Ciaanh/keyboards/Kanagawa/Oled/oled.md

https://randomnerdtutorials.com/guide-for-oled-display-with-arduino/

https://blog.squix.org/2016/10/font-creator-now-creates-adafruit-gfx-fonts.html

http://oleddisplay.squix.ch/#/home

https://joric.github.io/qle/  =>  fork https://github.com/Ciaanh/qle

http://teripom.x0.com/  => KO
https://helixfonteditor.netlify.com/
https://gist.github.com/teriyakichan/f1a38cd4c0ddd1238be15c48c8cf47d2
https://github.com/teriyakichan/helixfonteditor

https://github.com/qmk/qmk_firmware/issues/6650
