Ciaanh/keyboards/Kanagawa/rev2.1/kanagawa.jpg

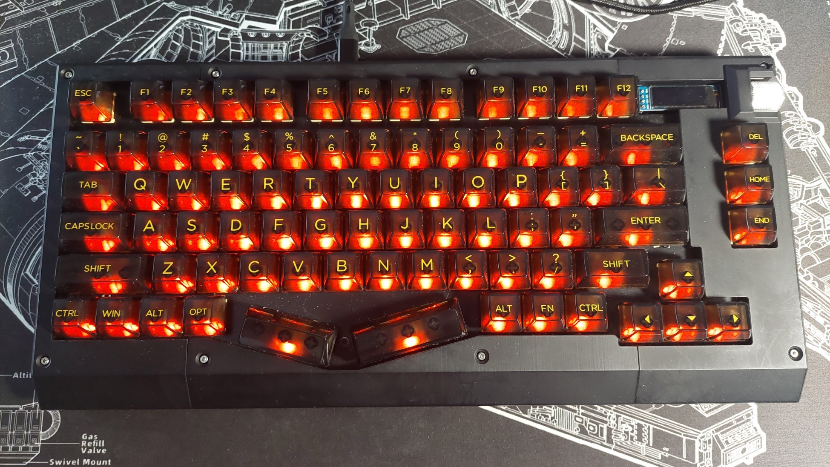
Kanagawa/rev2.1/kanagawa.jpg
