Ciaanh/keyboards/Kanagawa/rev2.1/kanagawa_built.jpg

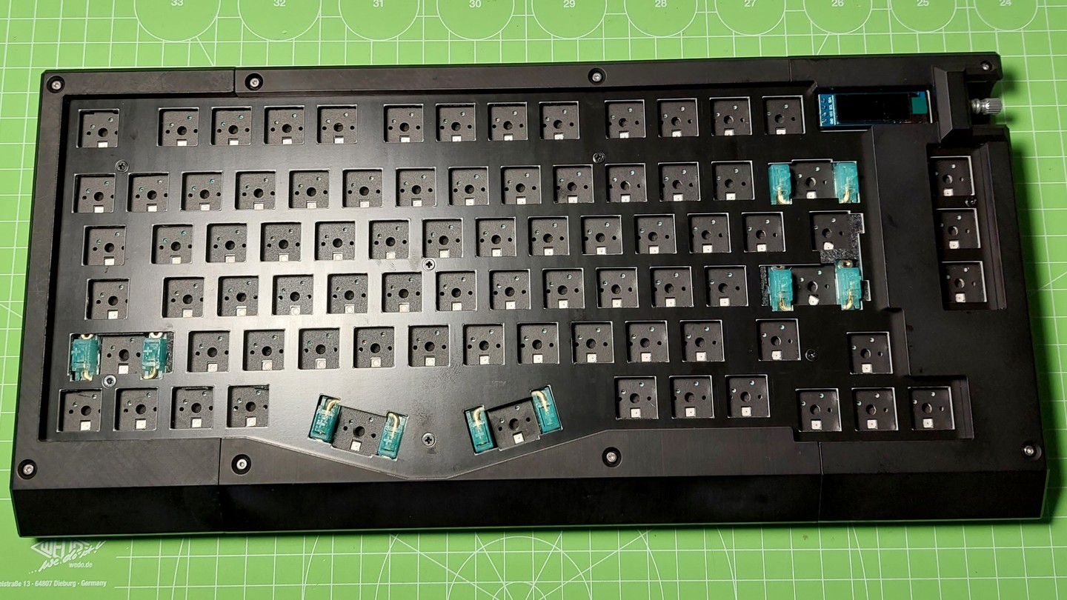
Kanagawa/rev2.1/kanagawa_built.jpg
