Ciaanh/keyboards/talk/pictures/Situation-under-control.png

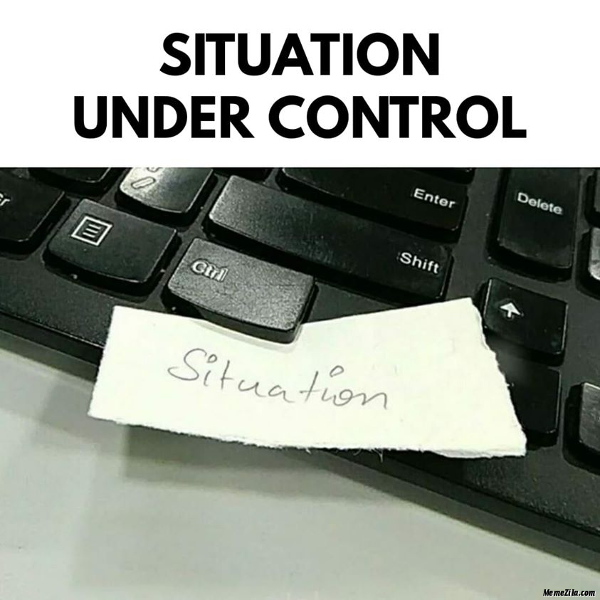
talk/pictures/Situation-under-control.png
