Ciaanh/keyboards/Board_MCU.xlsx

Sheet: Atmega32U4
Usage | Pin
 | B0
 | B1
 | B2
 | B3
 | B4
 | B5
 | B6
 | B7
 | C6
 | C7
 | D0
 | D1
 | D2
 | D3
 | D4
 | D5
 | D6
 | D7
 | E6
 | F0
 | F1
 | F4
 | F5
 | F6
 | F7

Sheet: Kanagawa
Label | Pin
col00 | B6
col01 | F0
col02 | F1
col03 | C7
col04 | D5
col05 | B7
col06 | B5
col07 | B4
col08 | E6
co0l9 | D7
col10 | C6
col11 | D4
col12 | D2
col13 | D3
row00 | B2
row01 | B3
row02 | B1
row03 | F7
row04 | F6
row05 | F5
SDA | D1
SCL | D0
ENCA | B0
ENCB | F4
RESET
VCC
GND

Sheet: Kanagawa RGB
Label | Pin
col00 | F1
col01 | C7
col02 | D5
col03 | B7
col04 | B5
col05 | B4
col06 | E6
col07 | D7
col08 | C6
co0l9 | D4
col10 | D3
col11 | D2
row00 | F0
row01 | B6
row02 | B2
row03 | B3
row04 | B1
row05 | F7
row06 | F6
SDA | D1
SCL | D0
RGB | B0
ENCA | F5
ENCB | F4
RESET
VCC
GND

Sheet: Kanagawa RGB Pico
Label | Pin Pico
col00 | GPIO2
col01 | GPIO3
col02 | GPIO4
col03 | GPIO5
col04 | GPIO6
col05 | GPIO7
col06 | GPIO8
col07 | GPIO9
col08 | GPIO10
co0l9 | GPIO11
col10 | GPIO12
col11 | GPIO13
col12 | GPIO14
col13 | GPIO15
row00 | GPIO27
row01 | GPIO26
row02 | GPIO21
row03 | GPIO20
row04 | GPIO19
row05 | GPIO18
SDA | GPIO16
SCL | GPIO17
RGB | GPIO28
ENCA | GPIO1
ENCB | GPIO0
RESET
VCC
GND
