Ciaanh/keyboards/Kanagawa/rev2.1/case/right.stl

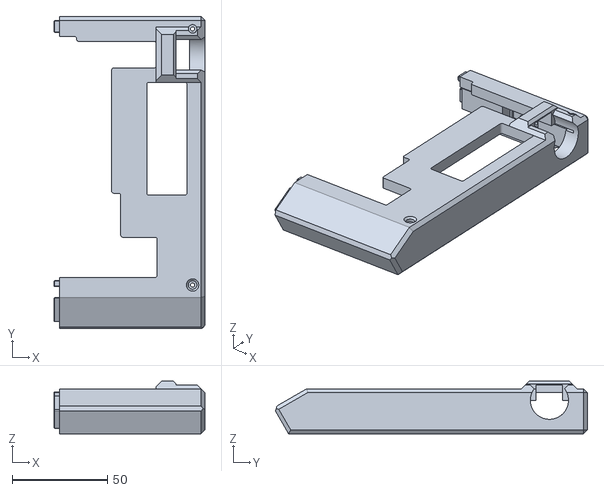
[picture p46: CAD file, 2023-05-08]
Kanagawa/rev2.1/case/right.stl
79.2 x 163.7 x 27.6
