Ciaanh/keyboards/Kanagawa/rev2.1/PCB_Projection_revised.dxf

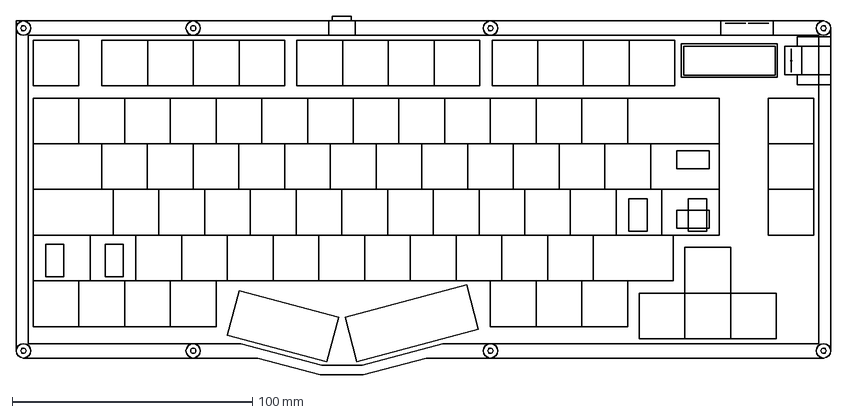
[picture p47: CAD file, 2023-04-29]
Kanagawa/rev2.1/PCB_Projection_revised.dxf
339.2 x 149.4 mm
