Ciaanh/keyboards/Kanagawa/rev2.1/case/top.stl

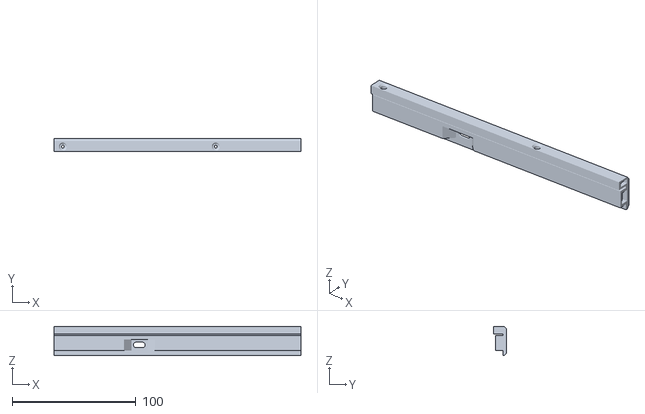
[picture p48: CAD file, 2023-05-08]
Kanagawa/rev2.1/case/top.stl
200.0 x 10.5 x 23.6
