Ciaanh/keyboards/Kanagawa/rev2.1/case/left.stl

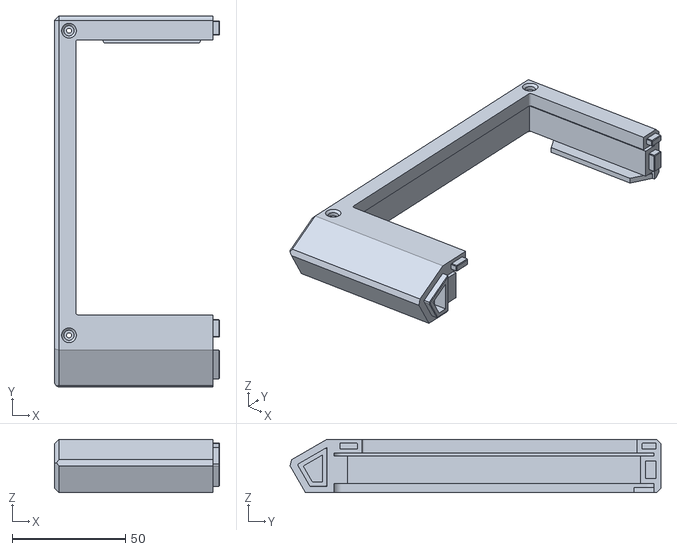
[picture p49: CAD file, 2023-05-08]
Kanagawa/rev2.1/case/left.stl
73.0 x 163.7 x 23.6
