Ciaanh/keyboards/Kanagawa/rev2.1/case/bottom.stl

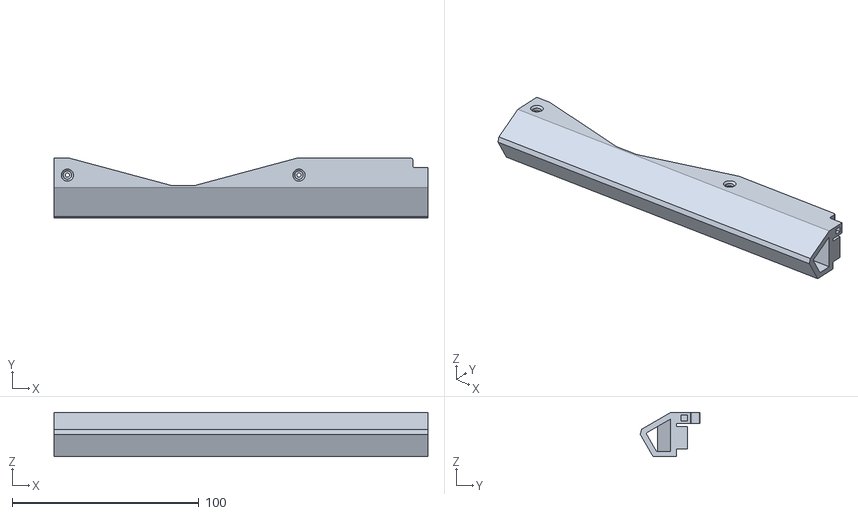
[picture p50: CAD file, 2023-05-08]
Kanagawa/rev2.1/case/bottom.stl
200.0 x 31.9 x 23.6
