Ciaanh/keyboards/Kanagawa/rev1/case/Right.stl

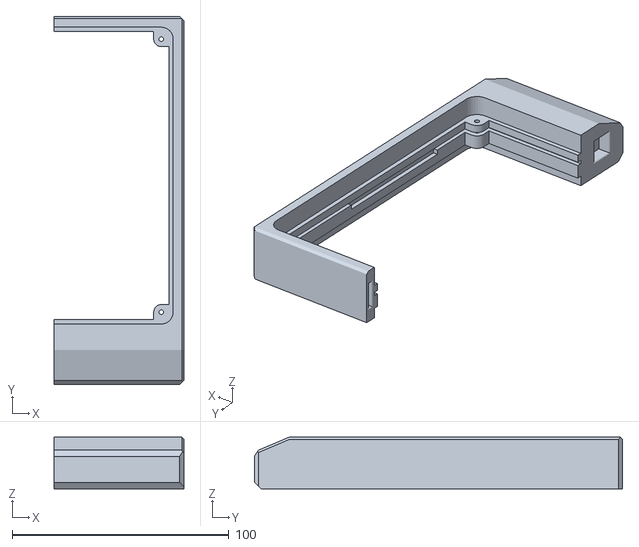
[picture p51: CAD file, 2022-02-07, an earlier design]
Kanagawa/rev1/case/Right.stl
60.0 x 170.0 x 23.8
