Ciaanh/keyboards/Kanagawa/rev1/Kanagawa-brd.dxf

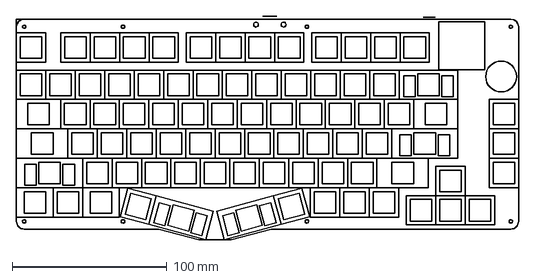
[picture p52: CAD file, 2022-02-07, an earlier design]
Kanagawa/rev1/Kanagawa-brd.dxf
325.0 x 144.9 mm
