Ciaanh/keyboards/Kanagawa/rev2/case/bottom.stl

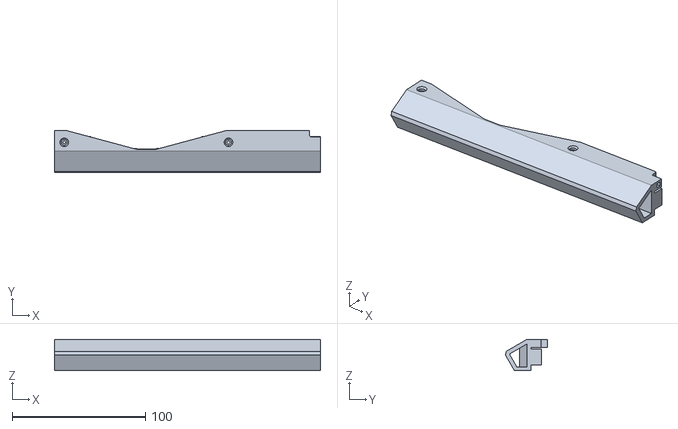
[picture p53: CAD file, 2023-04-29, an earlier design]
Kanagawa/rev2/case/bottom.stl
200.0 x 31.9 x 23.6
