Ciaanh/keyboards/Kanagawa/rev2/PCB_Projection.dxf

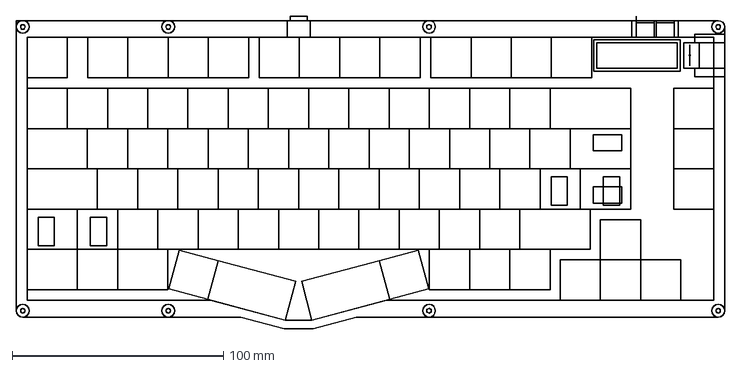
[picture p54: CAD file, 2023-04-29, an earlier design]
Kanagawa/rev2/PCB_Projection.dxf
335.2 x 147.9 mm
