Ciaanh/keyboards/Kanagawa/rev1/case/MiddleTop.stl

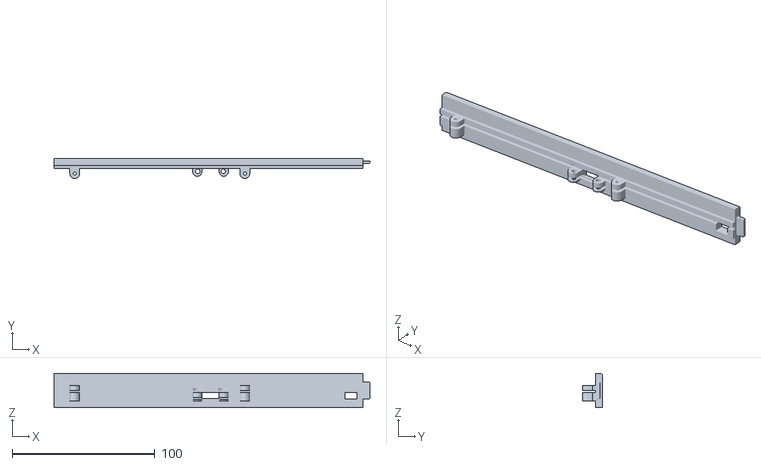
[picture p55: CAD file, 2022-02-07, an earlier design]
Kanagawa/rev1/case/MiddleTop.stl
221.0 x 14.0 x 23.8
