Ciaanh/keyboards/Kanagawa/rev2/case/left.stl

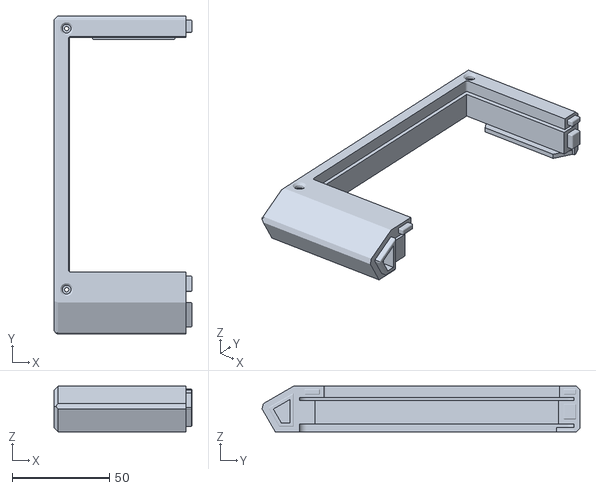
[picture p56: CAD file, 2023-04-29, an earlier design]
Kanagawa/rev2/case/left.stl
71.0 x 163.7 x 23.6
