Ciaanh/keyboards/Kanagawa/rev1/case/MiddleBottom.stl

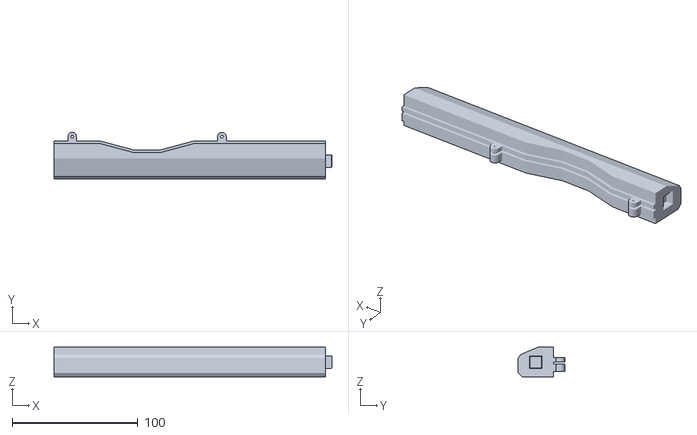
[picture p57: CAD file, 2022-02-07, an earlier design]
Kanagawa/rev1/case/MiddleBottom.stl
221.0 x 37.0 x 23.8
