Ciaanh/keyboards/Kanagawa/rev2/case/right.stl

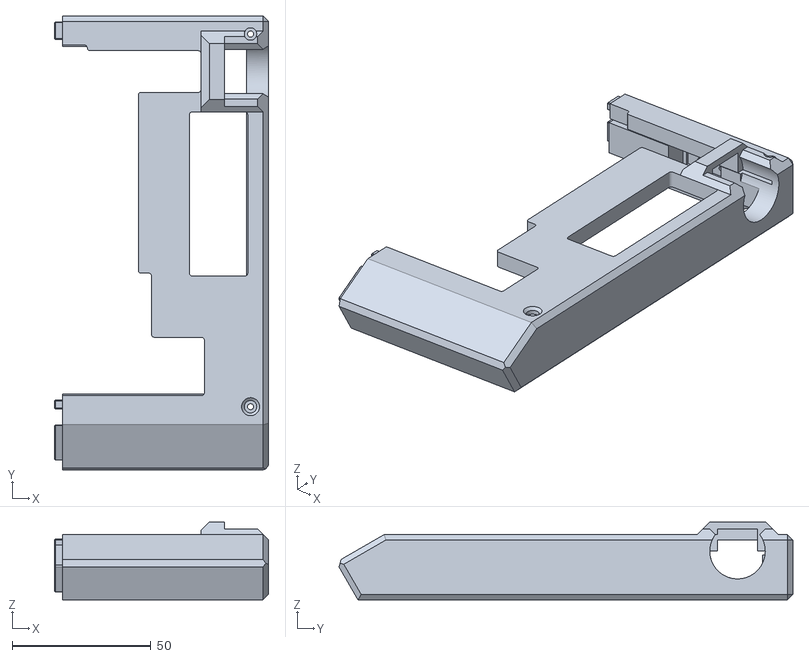
[picture p58: CAD file, 2023-04-29, an earlier design]
Kanagawa/rev2/case/right.stl
77.2 x 163.7 x 28.1
