Ciaanh/keyboards/Kanagawa/rev1/case/Left.stl

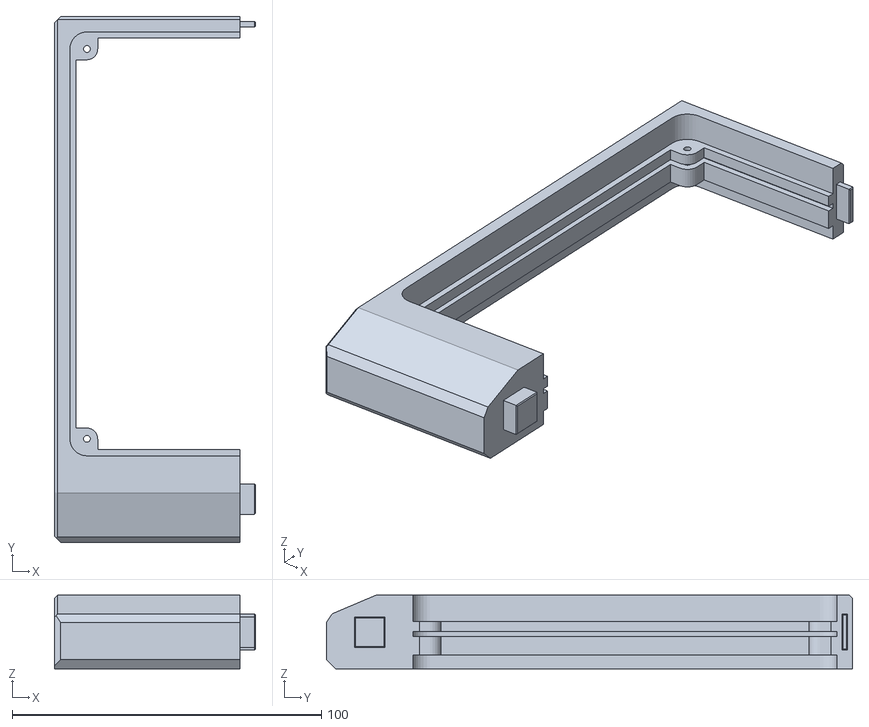
[picture p59: CAD file, 2022-02-07, an earlier design]
Kanagawa/rev1/case/Left.stl
65.0 x 170.0 x 23.8
