Ciaanh/keyboards/Kanagawa/rev2/case/top.stl

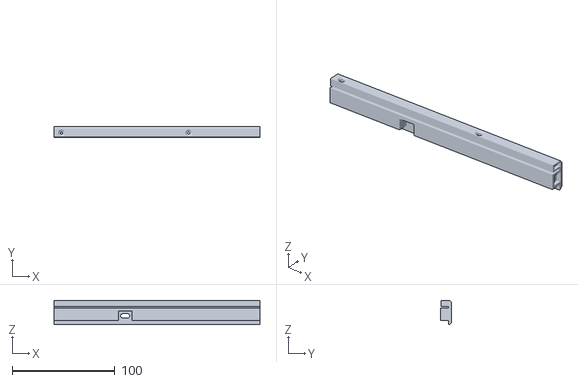
[picture p60: CAD file, 2023-04-29, an earlier design]
Kanagawa/rev2/case/top.stl
200.0 x 11.0 x 23.6
