Ciaanh/keyboards/(list of files, cad)

Other CAD files:
Kanagawa/rev1/case/Kanagawa-modified v12.f3d
