Ciaanh/keyboards/Pallas/Pallas.kicad_pcb

## KiCad design Pallas/Pallas.kicad_pcb (2021-02-15)

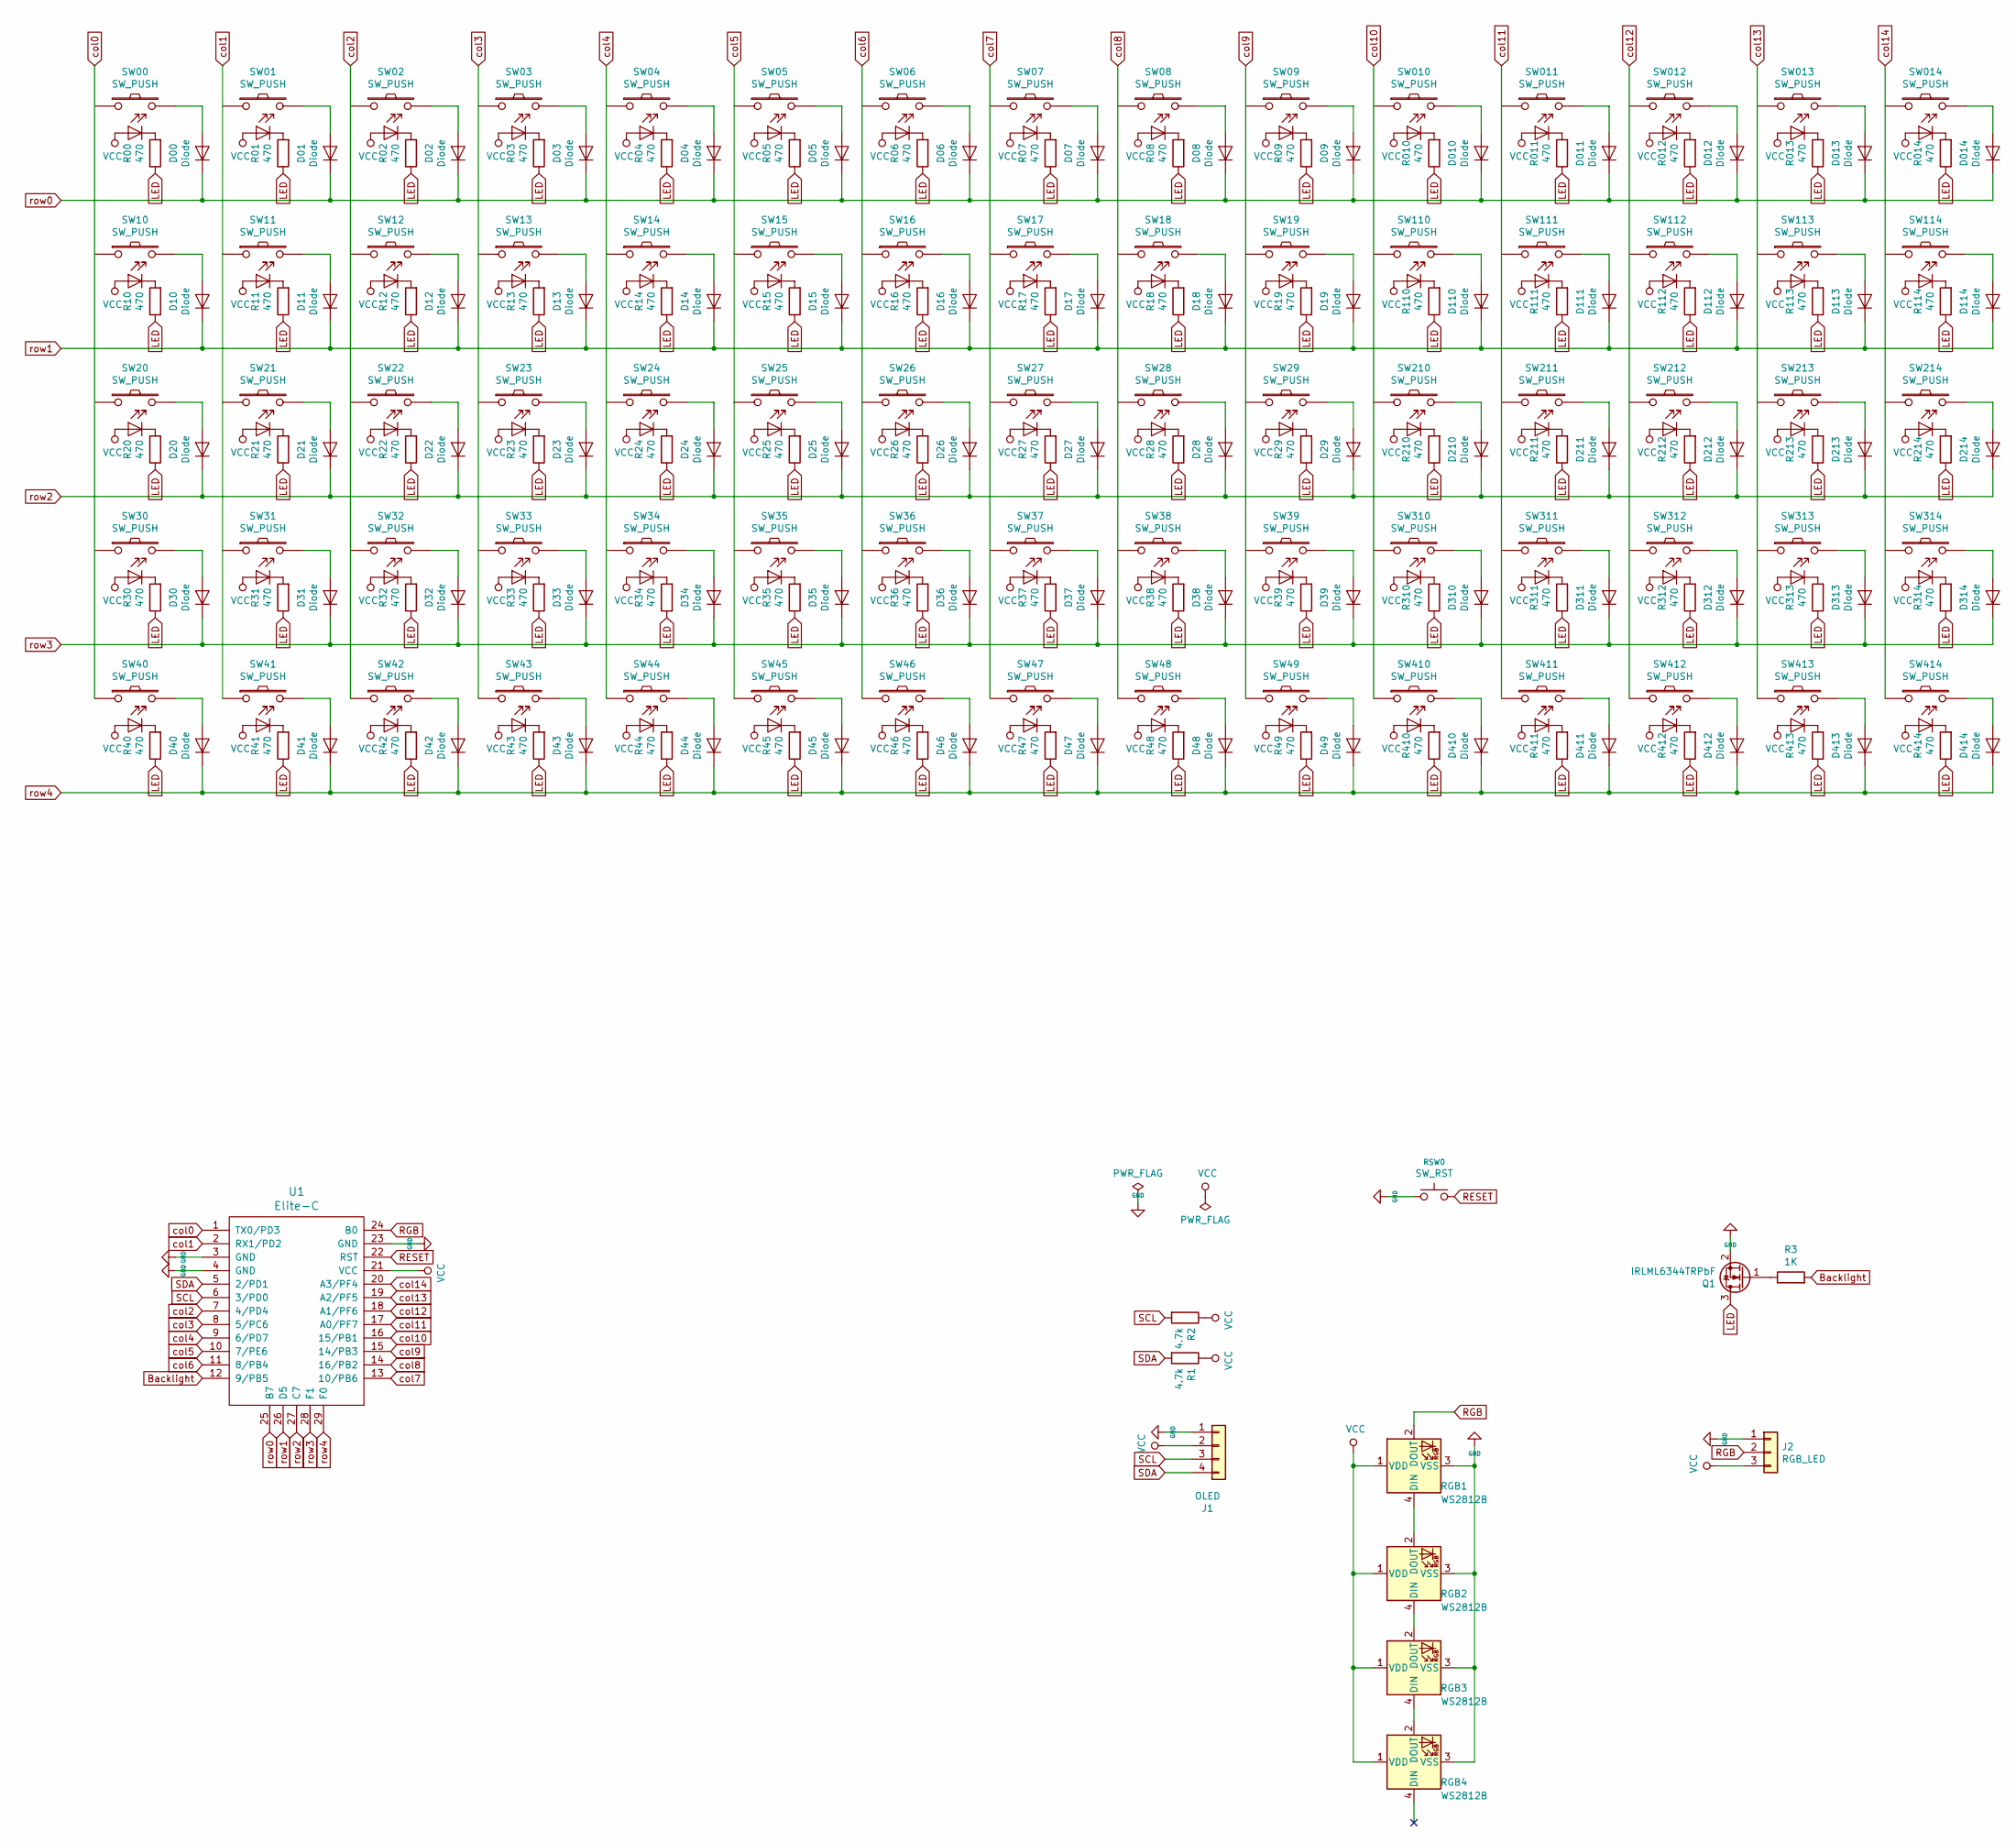
[picture p76: schematic Pallas.sch]

Parts:
D00, D01, D02, D03, D04, D05, D06, D07, D08, D09, D010, D10, D11, D011, D12, D012, D13, D013, D14, D014, D15, D16, D17, D18, D19, D20, D21, D22, D23, D24, D25, D26, D27, D28, D29, D30, D31, D32, D33, D34, D35, D36, D37, D38, D39, D40, D41, D42, D43, D44, D45, D46, D47, D48, D49, D110, D111, D112, D113, D114, D210, D211, D212, D213, D214, D310, D311, D312, D313, D314, D410, D411, D412, D413, D414: Diode; Diode_SMD_THT
J1: OLED; OLED_128x64_I2C
J2: RGB_LED; conn_3pins
Q1: IRLML6344TRPbF; SOT23-3_HSOL_Back
R00, R01, R02, R03, R04, R05, R06, R07, R08, R09, R010, R10, R11, R011, R12, R012, R13, R013, R14, R014, R15, R16, R17, R18, R19, R20, R21, R22, R23, R24, R25, R26, R27, R28, R29, R30, R31, R32, R33, R34, R35, R36, R37, R38, R39, R40, R41, R42, R43, R44, R45, R46, R47, R48, R49, R110, R111, R112, R113, R114, R210, R211, R212, R213, R214, R310, R311, R312, R313, R314, R410, R411, R412, R413, R414: 470; Resistors_SMD_THT
R1, R2: 4.7k; Resistors_SMD_THT
R3: 1K; Resistors_SMD_THT
RGB1, RGB2, RGB3, RGB4: WS2812B; WS2812B_Front
RSW0: SW_RST
SW00, SW01, SW02, SW03, SW04, SW05, SW06, SW07, SW08, SW09, SW010, SW11, SW011, SW12, SW012, SW13, SW013, SW14, SW014, SW15, SW16, SW17, SW18, SW19, SW21, SW22, SW23, SW24, SW25, SW26, SW27, SW28, SW29, SW31, SW32, SW33, SW34, SW35, SW36, SW37, SW38, SW39, SW43, SW46, SW47, SW48, SW49, SW110, SW111, SW112, SW113, SW114, SW210, SW211, SW212, SW213, SW310, SW311, SW312, SW313, SW410: SW_PUSH; SW_Cherry_MX_1.00u_PCB
SW10: SW_PUSH; SW_Cherry_MX_1.50u_PCB
SW20, SW314: SW_PUSH; SW_Cherry_MX_1.75u_PCB
SW30: SW_PUSH; SW_Cherry_MX_2.25u_PCB
SW40, SW41, SW42, SW45, SW411, SW413, SW414: SW_PUSH; SW_Cherry_MX_1.25u_PCB
SW44: SW_PUSH; SW_Cherry_MX_2.00u_PCB
SW214: SW_PUSH; SW_Cherry_MX_2.25u_ISO_PCB
SW412: SW_PUSH; SW_Cherry_MX_2.75u_PCB
U1: Elite-C; Elite-C-castellated-29pin-holes

Connections:
Backlight: R3.2, U1.12 (9/PB5)
GND: J1.1, J2.1, Q1.2 (S), RGB1.3 (VSS), RGB2.3 (VSS), RGB3.3 (VSS), RGB4.3 (VSS), RSW0.1, U1.3 (GND), U1.4 (GND), U1.23 (GND)
LED: Q1.3 (D), R00.1, R01.1, R02.1, R03.1, R04.1, R05.1, R06.1, R07.1, R08.1, R09.1, R10.1, R010.1, R11.1, R011.1, R012.1, R12.1, R13.1, R013.1, R014.1, R14.1, R15.1, R16.1, R17.1, R18.1, R19.1, R20.1, R21.1, R22.1, R23.1, R24.1, R25.1, R26.1, R27.1, R28.1, R29.1, R30.1, R31.1, R32.1, R33.1, R34.1, R35.1, R36.1, R37.1, R38.1, R39.1, R40.1, R41.1, R42.1, R43.1, R44.1, R45.1, R46.1, R47.1, R48.1, R49.1, R110.1, R111.1, R112.1, R113.1, R114.1, R210.1, R211.1, R212.1, R213.1, R214.1, R310.1, R311.1, R312.1, R313.1, R314.1, R410.1, R411.1, R412.1, R413.1, R414.1
unnamed: D00.2 (A), SW00.2
unnamed: D01.2 (A), SW01.2
unnamed: D02.2 (A), SW02.2
unnamed: D03.2 (A), SW03.2
unnamed: D04.2 (A), SW04.2
unnamed: D05.2 (A), SW05.2
unnamed: D06.2 (A), SW06.2
unnamed: D07.2 (A), SW07.2
unnamed: D08.2 (A), SW08.2
unnamed: D09.2 (A), SW09.2
unnamed: D010.2 (A), SW010.2
unnamed: D10.2 (A), SW10.2
unnamed: D011.2 (A), SW011.2
unnamed: D11.2 (A), SW11.2
unnamed: D012.2 (A), SW012.2
unnamed: D12.2 (A), SW12.2
unnamed: D013.2 (A), SW013.2
unnamed: D13.2 (A), SW13.2
unnamed: D014.2 (A), SW014.2
unnamed: D14.2 (A), SW14.2
unnamed: D15.2 (A), SW15.2
unnamed: D16.2 (A), SW16.2
unnamed: D17.2 (A), SW17.2
unnamed: D18.2 (A), SW18.2
unnamed: D19.2 (A), SW19.2
unnamed: D20.2 (A), SW20.2
unnamed: D21.2 (A), SW21.2
unnamed: D22.2 (A), SW22.2
unnamed: D23.2 (A), SW23.2
unnamed: D24.2 (A), SW24.2
unnamed: D25.2 (A), SW25.2
unnamed: D26.2 (A), SW26.2
unnamed: D27.2 (A), SW27.2
unnamed: D28.2 (A), SW28.2
unnamed: D29.2 (A), SW29.2
unnamed: D30.2 (A), SW30.2
unnamed: D31.2 (A), SW31.2
unnamed: D32.2 (A), SW32.2
unnamed: D33.2 (A), SW33.2
unnamed: D34.2 (A), SW34.2
unnamed: D35.2 (A), SW35.2
unnamed: D36.2 (A), SW36.2
unnamed: D37.2 (A), SW37.2
unnamed: D38.2 (A), SW38.2
unnamed: D39.2 (A), SW39.2
unnamed: D40.2 (A), SW40.2
unnamed: D41.2 (A), SW41.2
unnamed: D42.2 (A), SW42.2
unnamed: D43.2 (A), SW43.2
unnamed: D44.2 (A), SW44.2
unnamed: D45.2 (A), SW45.2
unnamed: D46.2 (A), SW46.2
unnamed: D47.2 (A), SW47.2
unnamed: D48.2 (A), SW48.2
unnamed: D49.2 (A), SW49.2
unnamed: D110.2 (A), SW110.2
unnamed: D111.2 (A), SW111.2
unnamed: D112.2 (A), SW112.2
unnamed: D113.2 (A), SW113.2
unnamed: D114.2 (A), SW114.2
unnamed: D210.2 (A), SW210.2
unnamed: D211.2 (A), SW211.2
unnamed: D212.2 (A), SW212.2
unnamed: D213.2 (A), SW213.2
unnamed: D214.2 (A), SW214.2
unnamed: D310.2 (A), SW310.2
unnamed: D311.2 (A), SW311.2
unnamed: D312.2 (A), SW312.2
unnamed: D313.2 (A), SW313.2
unnamed: D314.2 (A), SW314.2
unnamed: D410.2 (A), SW410.2
unnamed: D411.2 (A), SW411.2
unnamed: D412.2 (A), SW412.2
unnamed: D413.2 (A), SW413.2
unnamed: D414.2 (A), SW414.2
unnamed: Q1.1 (G), R3.1
unnamed: R00.2, SW00.4 (K)
unnamed: R01.2, SW01.4 (K)
unnamed: R02.2, SW02.4 (K)
unnamed: R03.2, SW03.4 (K)
unnamed: R04.2, SW04.4 (K)
unnamed: R05.2, SW05.4 (K)
unnamed: R06.2, SW06.4 (K)
unnamed: R07.2, SW07.4 (K)
unnamed: R08.2, SW08.4 (K)
unnamed: R09.2, SW09.4 (K)
unnamed: R010.2, SW010.4 (K)
unnamed: R10.2, SW10.4 (K)
unnamed: R011.2, SW011.4 (K)
unnamed: R11.2, SW11.4 (K)
unnamed: R012.2, SW012.4 (K)
unnamed: R12.2, SW12.4 (K)
unnamed: R013.2, SW013.4 (K)
unnamed: R13.2, SW13.4 (K)
unnamed: R014.2, SW014.4 (K)
unnamed: R14.2, SW14.4 (K)
unnamed: R15.2, SW15.4 (K)
unnamed: R16.2, SW16.4 (K)
unnamed: R17.2, SW17.4 (K)
unnamed: R18.2, SW18.4 (K)
unnamed: R19.2, SW19.4 (K)
unnamed: R20.2, SW20.4 (K)
unnamed: R21.2, SW21.4 (K)
unnamed: R22.2, SW22.4 (K)
unnamed: R23.2, SW23.4 (K)
unnamed: R24.2, SW24.4 (K)
unnamed: R25.2, SW25.4 (K)
unnamed: R26.2, SW26.4 (K)
unnamed: R27.2, SW27.4 (K)
unnamed: R28.2, SW28.4 (K)
unnamed: R29.2, SW29.4 (K)
unnamed: R30.2, SW30.4 (K)
unnamed: R31.2, SW31.4 (K)
unnamed: R32.2, SW32.4 (K)
unnamed: R33.2, SW33.4 (K)
unnamed: R34.2, SW34.4 (K)
unnamed: R35.2, SW35.4 (K)
unnamed: R36.2, SW36.4 (K)
unnamed: R37.2, SW37.4 (K)
unnamed: R38.2, SW38.4 (K)
unnamed: R39.2, SW39.4 (K)
unnamed: R40.2, SW40.4 (K)
unnamed: R41.2, SW41.4 (K)
unnamed: R42.2, SW42.4 (K)
unnamed: R43.2, SW43.4 (K)
unnamed: R44.2, SW44.4 (K)
unnamed: R45.2, SW45.4 (K)
unnamed: R46.2, SW46.4 (K)
unnamed: R47.2, SW47.4 (K)
unnamed: R48.2, SW48.4 (K)
unnamed: R49.2, SW49.4 (K)
unnamed: R110.2, SW110.4 (K)
unnamed: R111.2, SW111.4 (K)
unnamed: R112.2, SW112.4 (K)
unnamed: R113.2, SW113.4 (K)
unnamed: R114.2, SW114.4 (K)
unnamed: R210.2, SW210.4 (K)
unnamed: R211.2, SW211.4 (K)
unnamed: R212.2, SW212.4 (K)
unnamed: R213.2, SW213.4 (K)
unnamed: R214.2, SW214.4 (K)
unnamed: R310.2, SW310.4 (K)
unnamed: R311.2, SW311.4 (K)
unnamed: R312.2, SW312.4 (K)
unnamed: R313.2, SW313.4 (K)
unnamed: R314.2, SW314.4 (K)
unnamed: R410.2, SW410.4 (K)
unnamed: R411.2, SW411.4 (K)
unnamed: R412.2, SW412.4 (K)
unnamed: R413.2, SW413.4 (K)
unnamed: R414.2, SW414.4 (K)
RESET: RSW0.2, U1.22 (RST)
SCL: J1.3, R2.2, U1.6 (3/PD0)
SDA: J1.4, R1.2, U1.5 (2/PD1)
VCC: J1.2, J2.3, R1.1, R2.1, RGB1.1 (VDD), RGB2.1 (VDD), RGB3.1 (VDD), RGB4.1 (VDD), SW00.3 (A), SW01.3 (A), SW02.3 (A), SW03.3 (A), SW04.3 (A), SW05.3 (A), SW06.3 (A), SW07.3 (A), SW08.3 (A), SW09.3 (A), SW010.3 (A), SW10.3 (A), SW011.3 (A), SW11.3 (A), SW012.3 (A), SW12.3 (A), SW013.3 (A), SW13.3 (A), SW014.3 (A), SW14.3 (A), SW15.3 (A), SW16.3 (A), SW17.3 (A), SW18.3 (A), SW19.3 (A), SW20.3 (A), SW21.3 (A), SW22.3 (A), SW23.3 (A), SW24.3 (A), SW25.3 (A), SW26.3 (A), SW27.3 (A), SW28.3 (A), SW29.3 (A), SW30.3 (A), SW31.3 (A), SW32.3 (A), SW33.3 (A), SW34.3 (A), SW35.3 (A), SW36.3 (A), SW37.3 (A), SW38.3 (A), SW39.3 (A), SW40.3 (A), SW41.3 (A), SW42.3 (A), SW43.3 (A), SW44.3 (A), SW45.3 (A), SW46.3 (A), SW47.3 (A), SW48.3 (A), SW49.3 (A), SW110.3 (A), SW111.3 (A), SW112.3 (A), SW113.3 (A), SW114.3 (A), SW210.3 (A), SW211.3 (A), SW212.3 (A), SW213.3 (A), SW214.3 (A), SW310.3 (A), SW311.3 (A), SW312.3 (A), SW313.3 (A), SW314.3 (A), SW410.3 (A), SW411.3 (A), SW412.3 (A), SW413.3 (A), SW414.3 (A), U1.21 (VCC)
col0: SW00.1, SW10.1, SW20.1, SW30.1, SW40.1, U1.1 (TX0/PD3)
col1: SW01.1, SW11.1, SW21.1, SW31.1, SW41.1, U1.2 (RX1/PD2)
col2: SW02.1, SW12.1, SW22.1, SW32.1, SW42.1, U1.7 (4/PD4)
col3: SW03.1, SW13.1, SW23.1, SW33.1, SW43.1, U1.8 (5/PC6)
col4: SW04.1, SW14.1, SW24.1, SW34.1, SW44.1, U1.9 (6/PD7)
col5: SW05.1, SW15.1, SW25.1, SW35.1, SW45.1, U1.10 (7/PE6)
col6: SW06.1, SW16.1, SW26.1, SW36.1, SW46.1, U1.11 (8/PB4)
col7: SW07.1, SW17.1, SW27.1, SW37.1, SW47.1, U1.13 (10/PB6)
col8: SW08.1, SW18.1, SW28.1, SW38.1, SW48.1, U1.14 (16/PB2)
col9: SW09.1, SW19.1, SW29.1, SW39.1, SW49.1, U1.15 (14/PB3)
col10: SW010.1, SW110.1, SW210.1, SW310.1, SW410.1, U1.16 (15/PB1)
col11: SW011.1, SW111.1, SW211.1, SW311.1, SW411.1, U1.17 (A0/PF7)
col12: SW012.1, SW112.1, SW212.1, SW312.1, SW412.1, U1.18 (A1/PF6)
col13: SW013.1, SW113.1, SW213.1, SW313.1, SW413.1, U1.19 (A2/PF5)
col14: SW014.1, SW114.1, SW214.1, SW314.1, SW414.1, U1.20 (A3/PF4)
row0: D00.1 (K), D01.1 (K), D02.1 (K), D03.1 (K), D04.1 (K), D05.1 (K), D06.1 (K), D07.1 (K), D08.1 (K), D09.1 (K), D010.1 (K), D011.1 (K), D012.1 (K), D013.1 (K), D014.1 (K), U1.25 (B7)
row1: D10.1 (K), D11.1 (K), D12.1 (K), D13.1 (K), D14.1 (K), D15.1 (K), D16.1 (K), D17.1 (K), D18.1 (K), D19.1 (K), D110.1 (K), D111.1 (K), D112.1 (K), D113.1 (K), D114.1 (K), U1.26 (D5)
row2: D20.1 (K), D21.1 (K), D22.1 (K), D23.1 (K), D24.1 (K), D25.1 (K), D26.1 (K), D27.1 (K), D28.1 (K), D29.1 (K), D210.1 (K), D211.1 (K), D212.1 (K), D213.1 (K), D214.1 (K), U1.27 (C7)
row3: D30.1 (K), D31.1 (K), D32.1 (K), D33.1 (K), D34.1 (K), D35.1 (K), D36.1 (K), D37.1 (K), D38.1 (K), D39.1 (K), D310.1 (K), D311.1 (K), D312.1 (K), D313.1 (K), D314.1 (K), U1.28 (F1)
row4: D40.1 (K), D41.1 (K), D42.1 (K), D43.1 (K), D44.1 (K), D45.1 (K), D46.1 (K), D47.1 (K), D48.1 (K), D49.1 (K), D410.1 (K), D411.1 (K), D412.1 (K), D413.1 (K), D414.1 (K), U1.29 (F0)

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
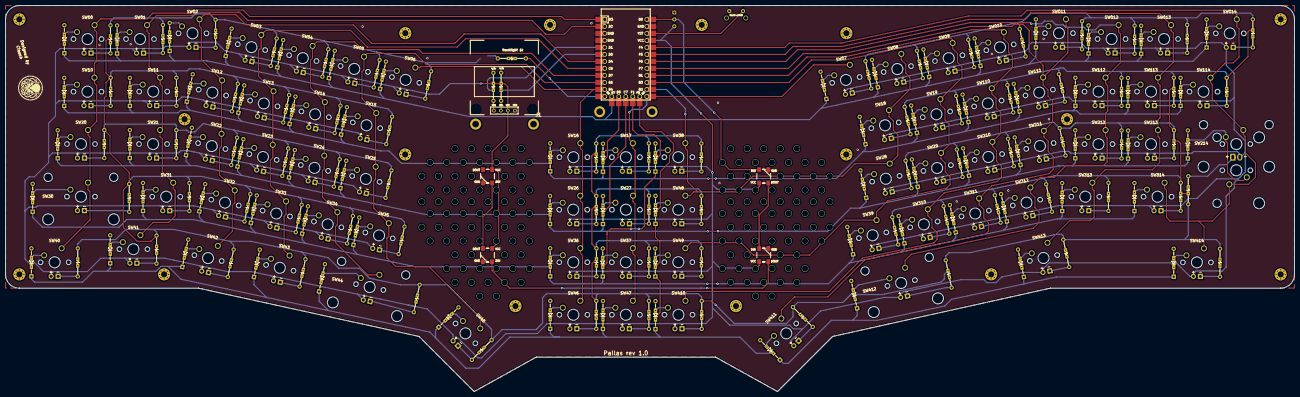
[picture p77: board Pallas.kicad_pcb from above]

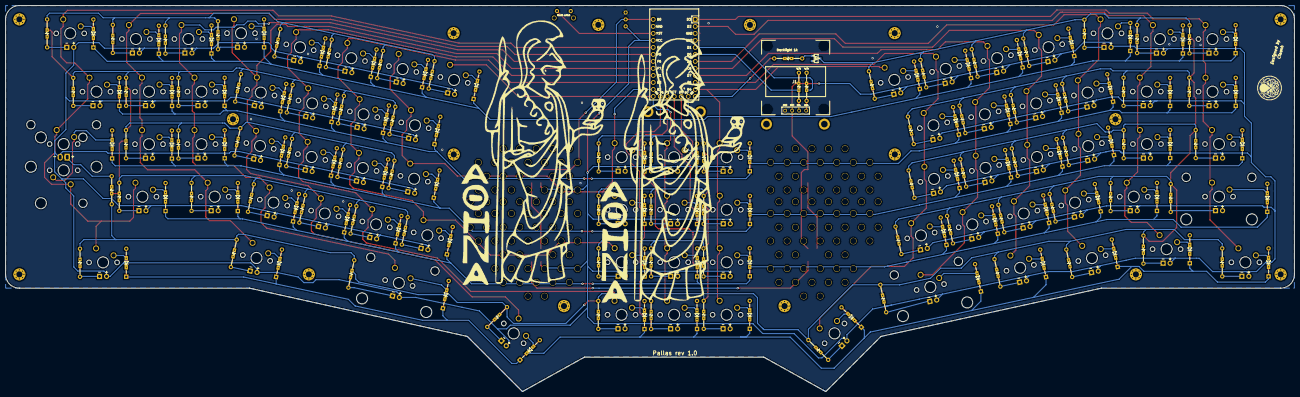
[picture p78: board Pallas.kicad_pcb from below]

Board: 2 copper layers, 467.5 x 140.0 mm, 262 parts (3 on the bottom side), 182 nets.

Other parts of the board:
DecorationHoleTop1, DecorationHoleTop2: DecorationHole
LogoBase1: LOGO; athena
LogoBaseMiddleTop: LOGO; Ciaanh_signature
LogoMiddle2: LOGO; athena
MountBaseMiddleTop0, MountBaseMiddleTop2, MountBaseMiddleTop3, MountBaseMiddleTop4, MountBaseMiddleTop5, MountBaseMiddleTop6, MountBaseMiddleTop7, MountBaseMiddleTop8, MountBaseMiddleTop9, MountBaseMiddleTop10, MountBaseMiddleTop11, MountBaseMiddleTop12, MountBaseMiddleTop13, MountBaseMiddleTop14, MountBaseMiddleTop15, MountBaseMiddleTop15#2: MountingHole; MountingHole_2.2mm_M2_Pad_Via
MountForMiddle1: HOLE; MountingHole_2.4mm_M2_Pad
MountMiddle1, MountMiddle2, MountMiddle3: HOLE; MountingHole_2.4mm_M2_Pad
