Ciaanh/keyboards/(commit log)

2020-06-01 Consolidate symbol and fp libraries
    [Pallas.kicad_pcb, Pallas.sch, base.kicad_pcb, middle.kicad_pcb, top.kicad_pcb]
2020-07-03 update pcb for footprint stabs
    [Pallas.kicad_pcb, base.kicad_pcb, middle.kicad_pcb, top.kicad_pcb]
2020-07-04 rev 0.2 fix diode an res position with stabs
    [Pallas.kicad_pcb, base.kicad_pcb, middle.kicad_pcb, top.kicad_pcb]
2020-07-05 Add decorations holes
    [Pallas.kicad_pcb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]
2020-07-05 Fix label switch label with stabs
    [Pallas.kicad_pcb]
2020-07-05 generate rev 0.2 pcbs
    [base.kicad_pcb, middle.kicad_pcb, top.kicad_pcb]
2020-07-05 Generate gerber files
    [base-B_Cu.gbl, base-B_Mask.gbs, base-B_SilkS.gbo, base-Edge_Cuts.gm1, base-F_Cu.gtl, base-F_Mask.gts, base-F_SilkS.gto, base.drl]
2020-09-09 Fix issue with label design by
    [Pallas.kicad_pcb, base.kicad_pcb, middle.kicad_pcb, top.kicad_pcb]
2020-12-27 Review diode and resistor position with stabs
    [Pallas.kicad_pcb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]
2021-01-05 update RGB led footprint and route
    [Pallas.kicad_pcb, base.kicad_pcb, middle.kicad_pcb, top.kicad_pcb]
2021-01-05 clean routes
    [Pallas.kicad_pcb]
2021-01-05 New routes
    [Pallas.kicad_pcb]
2021-01-07 Pallas rev 0.3
    [Pallas.kicad_pcb, base.kicad_pcb, middle.kicad_pcb, top.kicad_pcb]
2021-01-07 Update gerber
    [base-B_Cu.gbl, base-B_Mask.gbs, base-B_SilkS.gbo, base-Edge_Cuts.gm1, base-F_Cu.gtl, base-F_Mask.gts, base-F_SilkS.gto, base.drl]
2021-02-05 fix mosfet footprint
    [Pallas.kicad_pcb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]
2021-02-07 Edit oled footprint
    [Pallas.kicad_pcb]
2021-02-07 init project
    [Antikythera.kicad_pcb, Antikythera.sch]
2021-02-07 Split modules into seperate projects
    [Antikythera.sch, Board.kicad_pcb, Board.sch, Core.kicad_pcb, Core.sch]
2021-02-07 add link pcb
    [Link.kicad_pcb, Link.sch]
2021-02-07 link bridge
    [Link.kicad_pcb, Link.sch]
2021-02-15 improve link
    [Link.kicad_pcb, Link.sch]
2021-02-15 add hotswap footprint
    [Pallas.kicad_pcb]
2021-02-15 add reviung as ref for kanagawa
    [pcb-top-plate.kicad_pcb, pcb-top-plate.sch, reviung41.kicad_pcb, reviung41.sch]
2021-02-15 add test
    [Link.kicad_pcb, Link.sch, reviung41.kicad_pcb, reviung41.sch, test.kicad_pcb, test.sch]
2021-02-25 Test project
    [Link.kicad_pcb, Link.sch, pcb-top-plate.kicad_pcb, pcb-top-plate.sch, reviung41.kicad_pcb, reviung41.sch]
2021-03-11 add potential layout
    [Board.sch, Core.kicad_pcb, Core.sch, Link.kicad_pcb, Link.sch, drawing.kicad_pcb, kanagawa.kicad_pcb, kanagawa.sch]
2021-08-28 Create project Kanagawa with layout
    [Kanagawa.kicad_pcb, Kanagawa.sch, drawing.kicad_pcb, kanagawa.kicad_pcb, kanagawa.sch]
2021-09-02 Add footprints
    [Kanagawa.kicad_pcb, layout.kicad_pcb, layout.svg_5mm.stl]
2021-09-02 Begin placing footprints
    [Kanagawa.kicad_pcb, Kanagawa.sch]
2021-09-03 update footprint
    [Kanagawa.kicad_pcb, Kanagawa.sch]
2021-09-04 prepare pcb layout
    [Kanagawa.kicad_pcb, Kanagawa.sch]
2021-09-04 test footprint
2021-09-04 update pcb
    [Kanagawa.kicad_pcb, Kanagawa.sch]
2021-09-04 begin routes
    [Kanagawa.kicad_pcb]
2021-09-06 wip pcb
    [Kanagawa.kicad_pcb, Kanagawa.sch]
2021-09-07 wip routing
    [Kanagawa.kicad_pcb, Kanagawa.sch]
2021-09-09 rework routing
    [Kanagawa.kicad_pcb, Kanagawa.sch]
2021-09-12 Kanagawa routing
    [Kanagawa-B_Cu.gbr, Kanagawa-B_Mask.gbr, Kanagawa-B_Paste.gbr, Kanagawa-B_SilkS.gbr, Kanagawa-Edge_Cuts.gbr, Kanagawa-F_Cu.gbr, Kanagawa-F_Mask.gbr, Kanagawa-F_Paste.gbr]
2021-09-15 edit kanagawa
    [Kanagawa-B_Cu.gbr, Kanagawa-B_Mask.gbr, Kanagawa-B_Paste.gbr, Kanagawa-B_SilkS.gbr, Kanagawa-Edge_Cuts.gbr, Kanagawa-F_Cu.gbr, Kanagawa-F_Mask.gbr, Kanagawa-F_Paste.gbr]
2021-09-21 Add revisions
    [Kanagawa.kicad_pcb, Kanagawa.sch, kanagawa-base.kicad_pcb, kanagawa-middle.kicad_pcb, kanagawa-top.kicad_pcb]
2021-09-21 remove rev 2 generated
    [kanagawa-base.kicad_pcb, kanagawa-middle.kicad_pcb, kanagawa-top.kicad_pcb]
2021-09-21 edit rev2
    [Kanagawa.kicad_pcb]
2021-09-21 clean project
    [drawing.kicad_pcb, kanagawa.kicad_pcb, kanagawa.sch]
2021-10-02 clean revisions
    [Kanagawa.kicad_pcb, Kanagawa.sch, kanagawa-base.kicad_pcb, kanagawa-middle.kicad_pcb, kanagawa-top.kicad_pcb]
2021-10-02 routing rev1
    [Kanagawa.kicad_pcb]
2021-10-23 reviewe kanagawa rev1
    [Kanagawa.kicad_pcb, Kanagawa.sch, base.kicad_pcb, middle.kicad_pcb, top.kicad_pcb]
2021-10-24 edit arc for edge cut in script
    [base.kicad_pcb, middle.kicad_pcb, top.kicad_pcb]
2021-10-28 update script pcb generation
    [Kanagawa.kicad_pcb, base.kicad_pcb, middle.kicad_pcb, top.kicad_pcb]
2021-10-30 change R D footprint
    [Kanagawa.kicad_pcb]
2021-10-30 rev1 routing done
    [Kanagawa.kicad_pcb]
2021-11-11 edit pcb
    [Kanagawa.kicad_pcb]
2021-11-29 rework rev1 from fusion layout
    [Kanagawa-brd.dxf, Kanagawa.kicad_pcb, base.kicad_pcb, middle.kicad_pcb, revert-board.dxf, top-brd.dxf, top.kicad_pcb]
2021-12-01 review board
    [Kanagawa-brd.dxf, Kanagawa.kicad_pcb, adjust-edge.dxf, base.kicad_pcb, middle.kicad_pcb, revert-board.dxf, top-brd.dxf, top.kicad_pcb]
2021-12-18 review board edges
    [Kanagawa.kicad_pcb, adjust-edge.dxf]
2022-01-10 review PCB
    [BottomLeft.stl, BottomRight.stl, Kanagawa.kicad_pcb, TopLeft.stl, TopRight.stl, image2vector.dxf]
2022-01-10 generate kanagawa gerber
    [base-B_Cu.gbr, base-B_Mask.gbr, base-B_Paste.gbr, base-B_SilkS.gbr, base-Edge_Cuts.gbr, base-F_Cu.gbr, base-F_Mask.gbr, base-F_Paste.gbr]
2022-01-11 add rev1_rgb
    [Kanagawa-brd.dxf, Kanagawa.kicad_pcb, Kanagawa.sch, adjust-edge.dxf]
2022-01-23 Add new case stl
    [BottomLeft.stl, BottomRight.stl, Kanagawa.kicad_pcb, Kanagawa.kicad_sch, Kanagawa.sch, Left.stl, MiddleBottom.stl, MiddleTop.stl]
2022-01-30 re route pcbs
    [Kanagawa-brd.dxf, Kanagawa.kicad_pcb, Kanagawa.kicad_sch, Kanagawa.sch, Kanagawa_rgb.kicad_sch, adjust-edge.dxf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]
2022-02-07 release 1.0
    [Kanagawa_rgb.kicad_sch, adjust-edge.dxf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]
2022-06-18 wip rgb
    [BottomLeft.stl, BottomRight.stl, Kanagawa_rgb.kicad_sch, Left.stl, MiddleBottom.stl, MiddleTop.stl, Right.stl, TopLeft.stl]
2022-06-18 Separate iso and ansi format
    [Kanagawa_rgb.kicad_sch, Kanagawa_rgb_ansi.kicad_sch, Kanagawa_rgb_iso.kicad_sch, base.kicad_pcb, top.kicad_pcb]
2022-06-24 restart RGB
    [Kanagawa_rgb_ansi.kicad_sch, Kanagawa_rgb_encoder.kicad_pcb, Kanagawa_rgb_encoder.kicad_sch, Kanagawa_rgb_iso.kicad_sch, base.kicad_pcb, top.kicad_pcb]
2022-07-05 edit kanagawa rgb
    [Board_MCU.xlsx, Kanagawa_rgb_ansi.kicad_sch, Kanagawa_rgb_encoder-brd.dxf, Kanagawa_rgb_encoder.kicad_pcb]
2022-07-06 Begin routing ANSI
    [Board_MCU.xlsx, Kanagawa_rgb_ansi.kicad_sch, Kanagawa_rgb_encoder-brd.dxf, Kanagawa_rgb_encoder.kicad_pcb, Kanagawa_rgb_encoder.kicad_sch, PCB_Projection.dxf, base.kicad_pcb, top.kicad_pcb]
2022-07-17 rework rev2 kanagawa
    [Encoder.dxf, Kanagawa_rgb_ansi.kicad_sch, PCB_Projection.dxf]
2022-07-29 add stamp version
    [Kanagawa_rgb_ansi.kicad_sch, Kanagawa_rgb_ansi_stamp.kicad_sch, Kanagawa_rgb_encoder-brd.dxf, Kanagawa_rgb_encoder.kicad_pcb, Kanagawa_rgb_encoder.kicad_sch, PCB_Projection.dxf, base.kicad_pcb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]
2022-08-04 edit stamp version
    [Kanagawa_rgb_ansi.kicad_sch, Kanagawa_rgb_ansi_stamp.kicad_sch]
2022-08-06 work on rev2 changes
    [Kanagawa_rgb_ansi_stamp.kicad_sch, PCB_Projection.dxf]
2022-12-11 add v2 H
    [Case_Border_Bottom.stl, Case_Border_Left.stl, Case_Border_Right 2.stl, Case_Border_Right.stl, Case_Border_Top.stl, Kanagawa_rgb_ansi.kicad_sch, Kanagawa_rgb_ansi_pico.kicad_sch, Kanagawa_rgb_iso_pico.kicad_sch]
2022-12-11 edit iso H
    [Kanagawa_rgb_iso_pico.kicad_sch]
2022-12-11 H version
    [top.kicad_pcb]
2022-12-12 iso H
    [Case_Border_Bottom.stl, Case_Border_Left.stl, Case_Border_Right (1).stl, Case_Border_Right.stl, Case_Border_Top.stl, Kanagawa_rgb_iso_pico.kicad_sch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]
2022-12-12 gerber H
    [middle-B_Cu.gbr, middle-B_Mask.gbr, middle-B_Paste.gbr, middle-B_Silkscreen.gbr, middle-Edge_Cuts.gbr, middle-F_Cu.gbr, middle-F_Mask.gbr, middle-F_Paste.gbr]
2023-01-29 adjust kanagawa rev2 pcbs
    [Case_Border_Bottom.stl, Case_Border_Left.stl, Case_Border_Right (1).stl, Case_Border_Right.stl, Case_Border_Top.stl, Encoder.dxf, Kanagawa_rgb_ansi_pico.kicad_sch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]
2023-03-10 edit Kanagawa PCB
    [Kanagawa_rgb_ansi_pico.kicad_sch, Kanagawa_rgb_iso_pico.kicad_sch, Kanagawa_rgb_pico.kicad_sch, top.kicad_pcb]
2023-04-29 add case files
    [Case_Border_Bottom.stl, Case_Border_Left.stl, Case_Border_Right 2.stl, Case_Border_Right.stl, Case_Border_Top.stl, Kanagawa-modified v12.f3d, Kanagawa_rgb_ansi_pico.kicad_sch, Kanagawa_rgb_pico.kicad_sch]
2023-05-08 update kanagawa rev2.1 case files
    [bottom.stl, left.stl, right.stl, top.stl]
2023-05-08 fix files ref
    [bottom.stl, left.stl, right.stl, top.stl]
2024-01-09 Edit excel led matrix
2024-01-09 edit matrix file
    [RGB_matrix_rev2.xlsx]
